sssata/load_cell_reader/FW/loadcellreader/scripts/noise_analysis.png

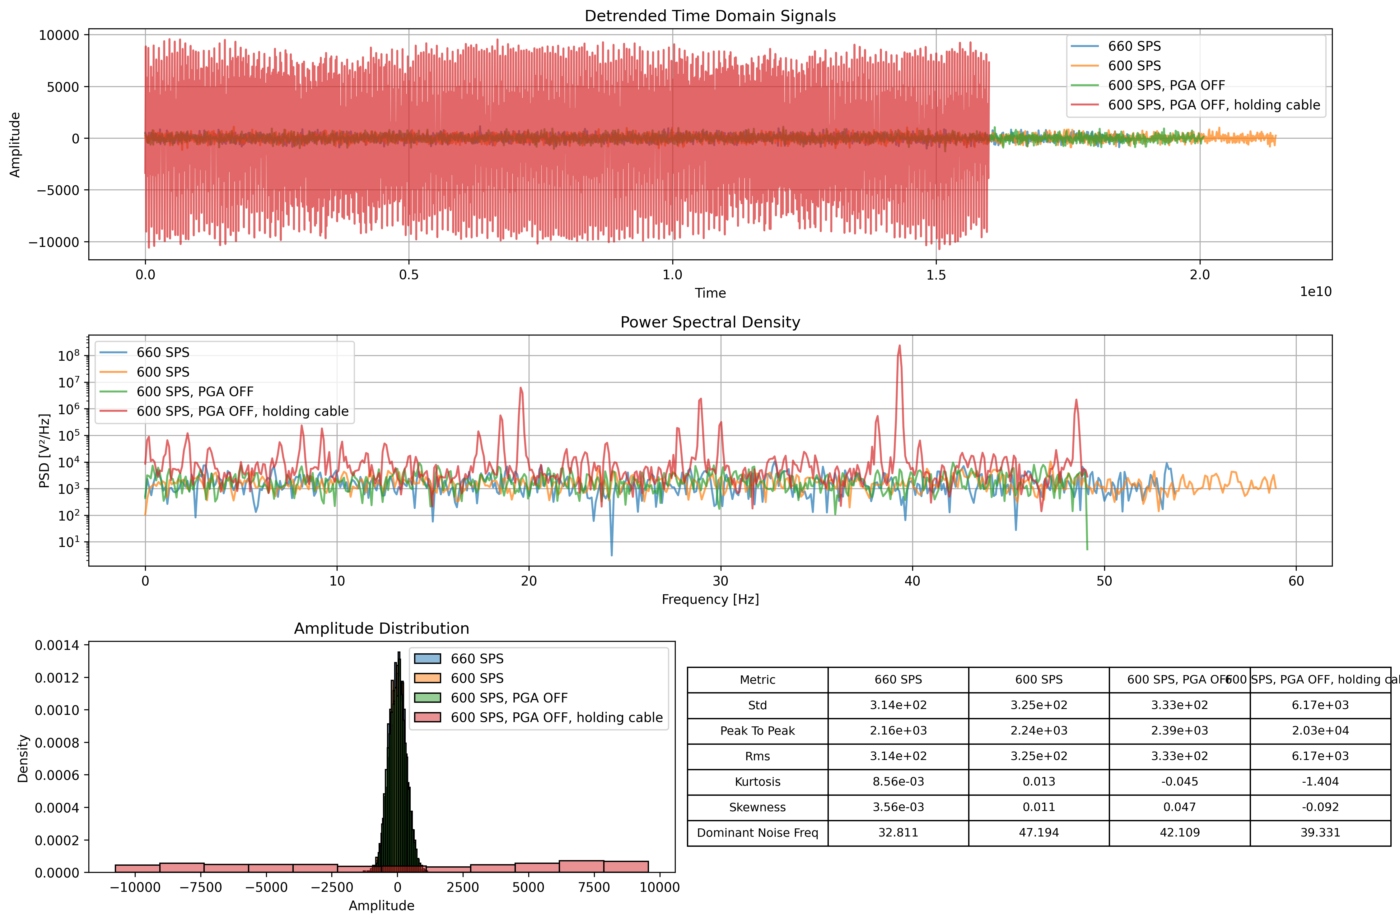
FW/loadcellreader/scripts/noise_analysis.png
