sssata/load_cell_reader/ECAD/ads1220_board/ads1220_board.kicad_pcb

## KiCad design ECAD/ads1220_board/ads1220_board.kicad_pcb (2024-11-20)

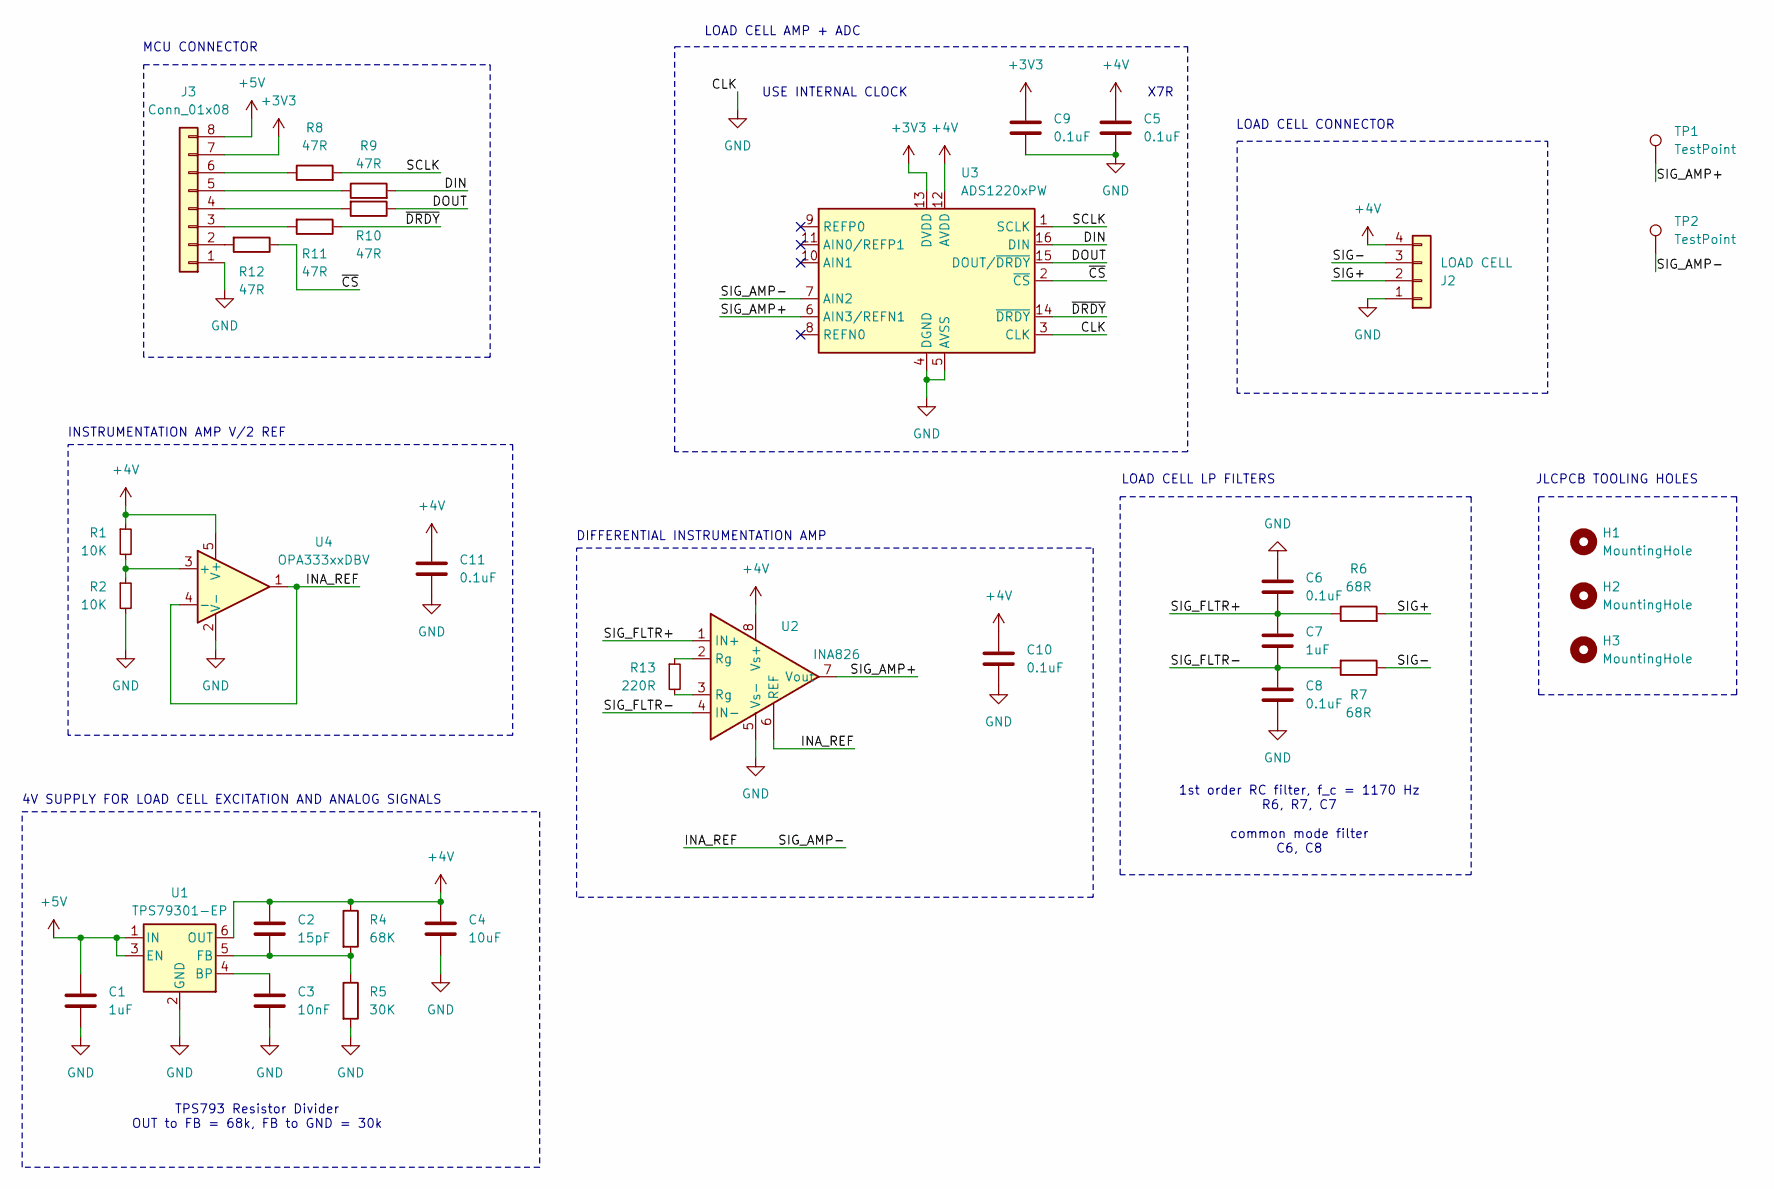
[picture p2: schematic ads1220_board.kicad_sch]

Parts:
C1, C7: 1uF; C_0402_1005Metric; JLC PN C52923
C2: 15pF; C_0402_1005Metric; JLC PN C1548
C3: 10nF; C_0402_1005Metric; JLC PN C15195
C4: 10uF; C_0603_1608Metric; JLC PN C19702
C5, C6, C8, C9, C10, C11: 0.1uF; C_0402_1005Metric; JLC PN C307331
H1, H2, H3: MountingHole; SMD Tooling Hole
J2: LOAD CELL; JST_PH_B4B-PH-K_1x04_P2.00mm_Vertical
J3: Conn_01x08; JST_PH_B8B-PH-K_1x08_P2.00mm_Vertical
R1, R2: 10K; R_0402_1005Metric; JLC PN C25744
R4: 68K; R_0603_1608Metric; JLC PN C23231
R5: 30K; R_0603_1608Metric; JLC PN C22984
R6, R7: 68R; R_0402_1005Metric; JLC PN C25131
R8, R9, R10, R11, R12: 47R; R_0603_1608Metric; JLC PN C23182
R13: 220R; R_0402_1005Metric; JLC PN C25091
TP1, TP2: TestPoint; TestPoint_Pad_1.0x1.0mm
U1: TPS79301-EP; SOT-23-6
U2: INA826; Texas_S-PDSO-G8_3x3mm_P0.65mm
U3: ADS1220xPW; TSSOP-16_4.4x5mm_P0.65mm
U4: OPA333xxDBV; SOT-23-5

Connections:
+3V3: C9.2, J3.7, U3.13 (DVDD)
+4V: C2.1, C4.1, C5.2, C10.2, C11.2, J2.4, R1.1, R4.1, U1.6 (OUT), U2.8 (Vs+), U3.12 (AVDD), U4.5 (V+)
+5V: C1.1, J3.8, U1.1 (IN), U1.3 (EN)
/DIN: R9.2, U3.16 (DIN)
/DOUT: R10.1, U3.15 (DOUT/~DRDY)
/INA_REF: TP2.1, U2.6 (REF), U3.7 (AIN2), U4.1, U4.4 (-)
/SCLK: R8.2, U3.1 (SCLK)
/SIG+: J2.2, R6.2
/SIG-: J2.3, R7.1
/SIG_AMP+: TP1.1, U2.7 (Vout), U3.6 (AIN3/REFN1)
/SIG_FLTR+: C6.2, C7.1, R6.1, U2.1 (IN+)
/SIG_FLTR-: C7.2, C8.1, R7.2, U2.4 (IN-)
/~CS: R12.1, U3.2 (~CS)
/~DRDY: R11.1, U3.14 (~DRDY)
GND: C1.2, C3.2, C4.2, C5.1, C6.1, C8.2, C9.1, C10.1, C11.1, J2.1, J3.1, R2.2, R5.2, U1.2 (GND), U2.5 (Vs-), U3.3 (CLK), U3.4 (DGND), U3.5 (AVSS), U4.2 (V-)
unnamed: J3.2, R12.2
unnamed: J3.3, R11.2
unnamed: J3.4, R10.2
unnamed: J3.5, R9.1
unnamed: J3.6, R8.1
unnamed: R13.1, U2.2 (Rg)
unnamed: R13.2, U2.3 (Rg)
unnamed: C3.1, U1.4 (BP)
unnamed: C2.2, R4.2, R5.1, U1.5 (FB)
unnamed: R1.2, R2.1, U4.3 (+)

Notes on the sheet:
X7R
INSTRUMENTATION AMP V/2 REF
JLCPCB TOOLING HOLES
LOAD CELL LP FILTERS
1st order RC filter, f_c = 1170 Hz R6, R7, C7 common mode filter C6, C8
LOAD CELL CONNECTOR
TPS793 Resistor Divider OUT to FB = 68k, FB to GND = 30k
MCU CONNECTOR
USE INTERNAL CLOCK
DIFFERENTIAL INSTRUMENTATION AMP
4V SUPPLY FOR LOAD CELL EXCITATION AND ANALOG SIGNALS
LOAD CELL AMP + ADC

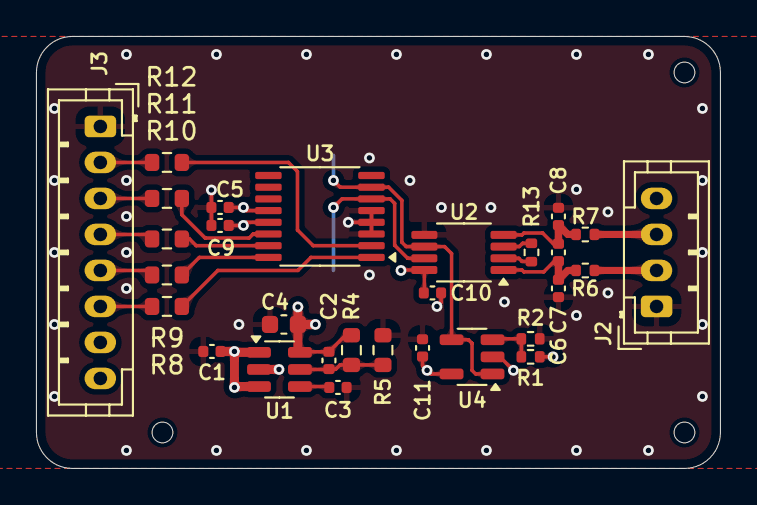
[picture p3: board ads1220_board.kicad_pcb from above]

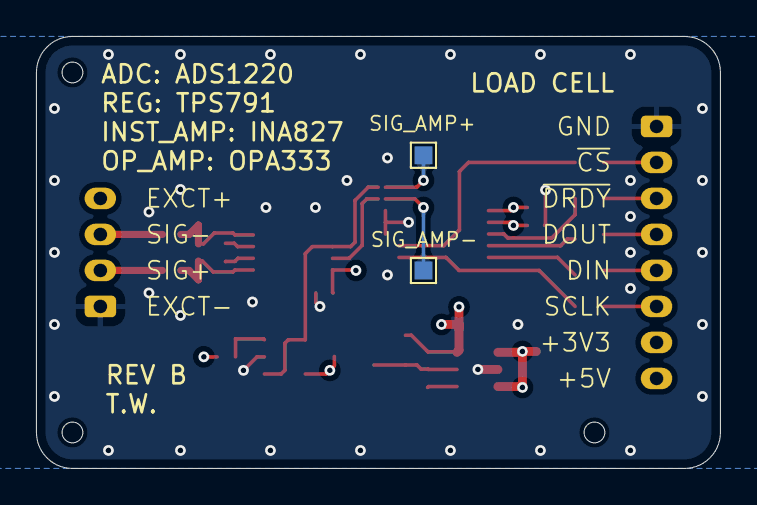
[picture p4: board ads1220_board.kicad_pcb from below]

Board: 4 copper layers, 38.0 x 24.0 mm, 34 parts (2 on the bottom side), 25 nets.
