sssata/load_cell_reader/ECAD/ads1260_board/ads1260_board.kicad_pcb

## KiCad design ECAD/ads1260_board/ads1260_board.kicad_pcb (2024-05-06)

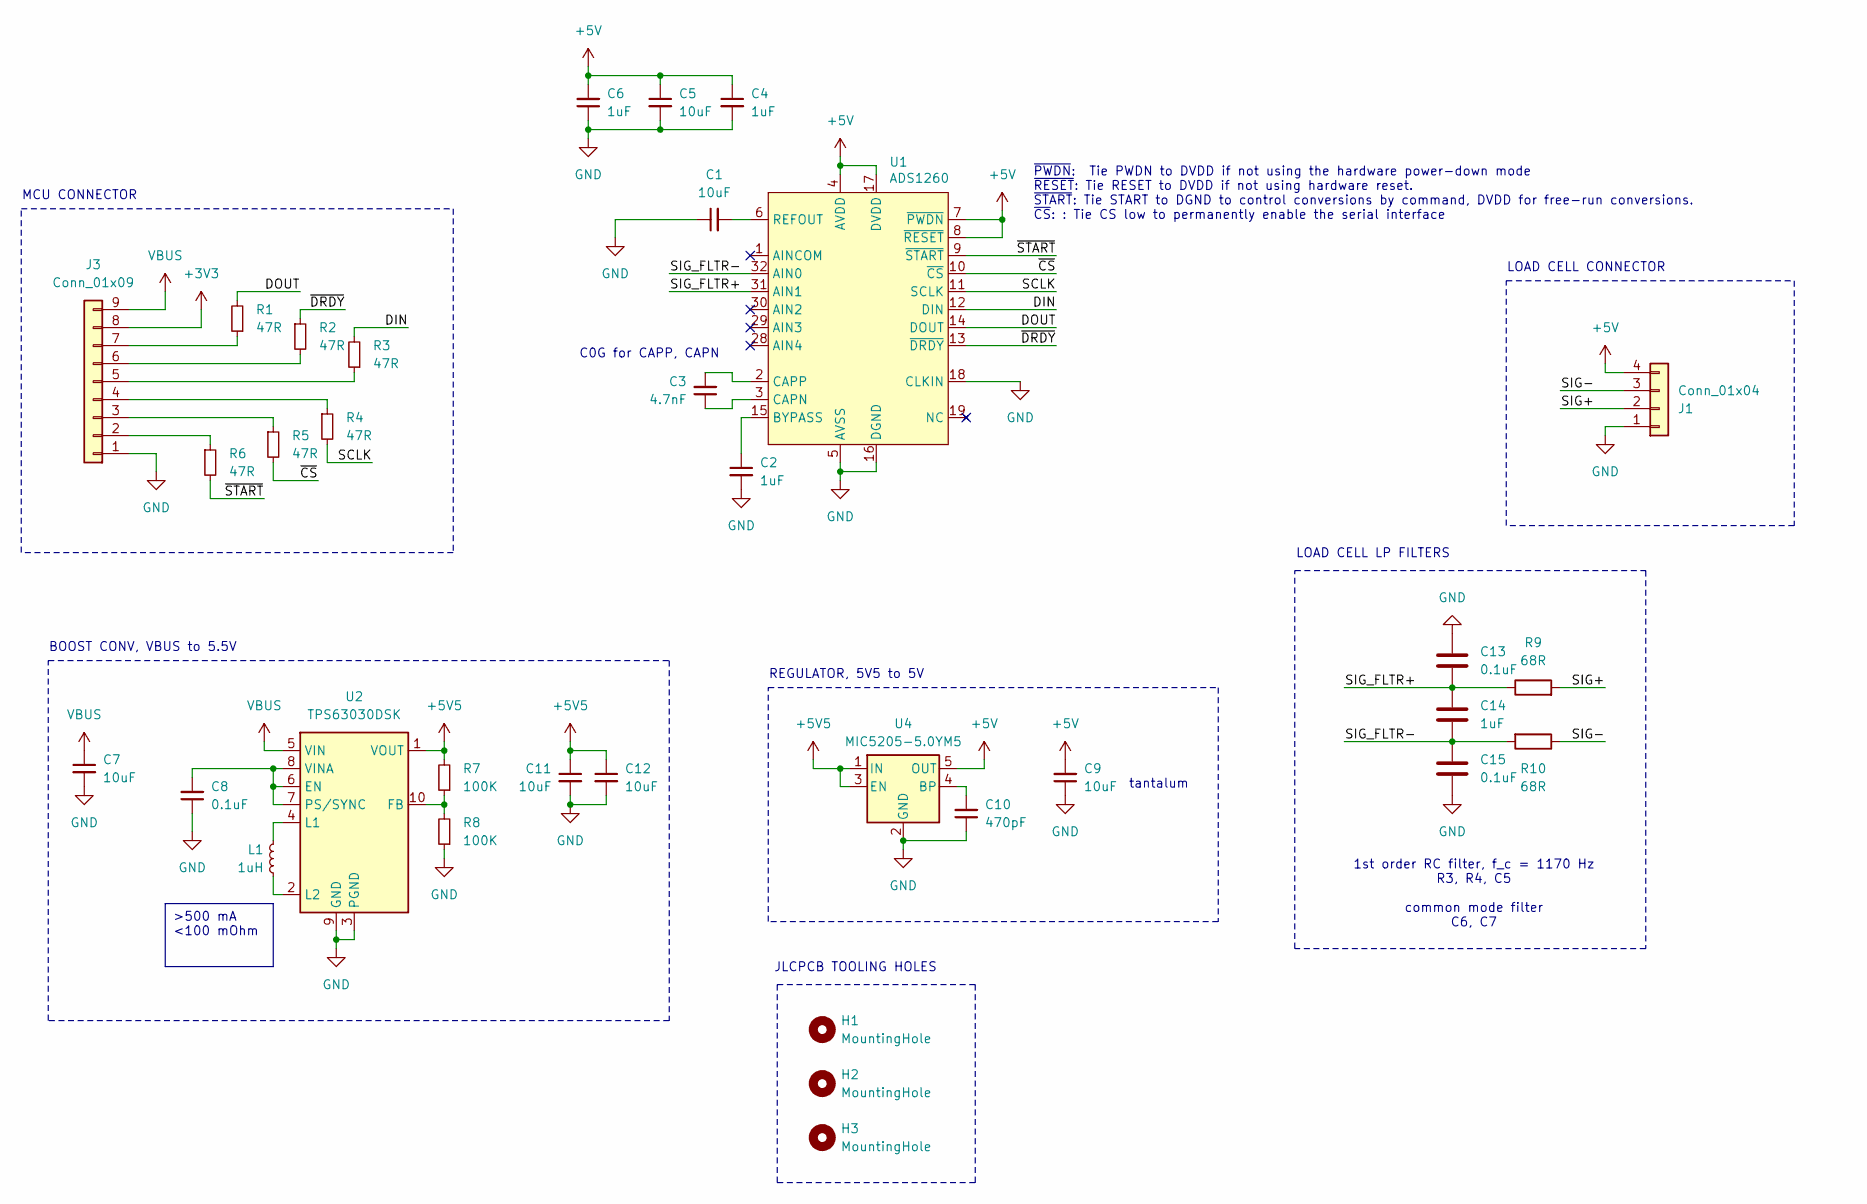
[picture p5: schematic ads1260_board.kicad_sch]

Parts:
C1, C5, C7, C9, C11, C12: 10uF; C_0603_1608Metric
C2, C4, C6, C14: 1uF; C_0402_1005Metric
C3: 4.7nF; C_0402_1005Metric
C8, C13, C15: 0.1uF; C_0402_1005Metric
C10: 470pF; C_0603_1608Metric
H1, H2, H3: MountingHole; SMD Tooling Hole
J1: Conn_01x04; JST_PH_B4B-PH-K_1x04_P2.00mm_Vertical
J3: Conn_01x09; JST_PH_B9B-PH-K_1x09_P2.00mm_Vertical
L1: 1uH; L_Murata_DFE201610P
R1, R2, R3, R4, R5, R6: 47R; R_0402_1005Metric
R7, R8: 100K; R_0402_1005Metric
R9, R10: 68R; R_0402_1005Metric
U1: ADS1260; VQFN-32-1EP_5x5mm_P0.5mm_EP3.15x3.15mm
U2: TPS63030DSK; WSON-10-1EP_2.5x2.5mm_P0.5mm_EP1.2x2mm
U4: MIC5205-5.0YM5; SOT-23-5

Connections:
+3V3: J3.8
+5V: C4.1, C5.1, C6.2, C9.2, J1.4, U1.4 (AVDD), U1.7 (~PWDN), U1.8 (~RESET), U1.17 (DVDD), U4.5 (OUT)
+5V5: C11.1, C12.1, R7.2, U2.1 (VOUT), U4.1 (IN), U4.3 (EN)
/DIN: R3.2, U1.12 (DIN)
/DOUT: R1.2, U1.14 (DOUT)
/SCLK: R4.2, U1.11 (SCLK)
/SIG+: J1.2, R9.2
/SIG-: J1.3, R10.1
/SIG_FLTR+: C13.2, C14.1, R9.1, U1.31 (AIN1)
/SIG_FLTR-: C14.2, C15.1, R10.2, U1.32 (AIN0)
/~CS: R5.2, U1.10 (~CS)
/~DRDY: R2.1, U1.13 (~DRDY)
/~START: R6.2, U1.9 (~START)
GND: C1.1, C2.2, C4.2, C5.2, C6.1, C7.2, C8.1, C9.1, C10.1, C11.2, C12.2, C13.1, C15.2, J1.1, J3.1, R8.1, U1.5 (AVSS), U1.16 (DGND), U1.18 (CLKIN), U1.33 (AVSS), U2.3 (PGND), U2.9 (GND), U2.11 (PGND), U4.2 (GND)
unnamed: J3.2, R6.1
unnamed: J3.3, R5.1
unnamed: J3.4, R4.1
unnamed: J3.5, R3.1
unnamed: J3.6, R2.2
unnamed: J3.7, R1.1
unnamed: C2.1, U1.15 (BYPASS)
unnamed: C3.1, U1.3 (CAPN)
unnamed: C3.2, U1.2 (CAPP)
unnamed: C1.2, U1.6 (REFOUT)
unnamed: C8.2, U2.6 (EN), U2.7 (PS/SYNC), U2.8 (VINA)
unnamed: R7.1, R8.2, U2.10 (FB)
unnamed: L1.2, U2.4 (L1)
unnamed: L1.1, U2.2 (L2)
unnamed: C10.2, U4.4 (BP)
VBUS: C7.1, J3.9, U2.5 (VIN)

Notes on the sheet:
>500 mA <100 mOhm
tantalum
REGULATOR, 5V5 to 5V
~{PWDN}: Tie PWDN to DVDD if not using the hardware power-down mode ~{RESET}: Tie RESET to DVDD if not using hardware reset. ~{START}: Tie START to DGND to control conversions by command, DVDD for free-run conversions. ~{CS}: : Tie CS low to permanently enable the serial interface
BOOST CONV, VBUS to 5.5V
MCU CONNECTOR
LOAD CELL LP FILTERS
1st order RC filter, f_c = 1170 Hz R3, R4, C5 common mode filter C6, C7
JLCPCB TOOLING HOLES
LOAD CELL CONNECTOR
C0G for CAPP, CAPN

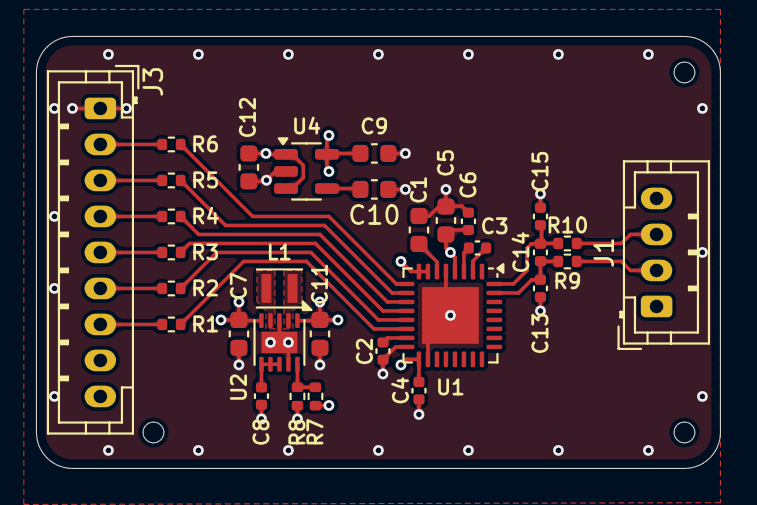
[picture p6: board ads1260_board.kicad_pcb from above]

Board: 4 copper layers, 38.0 x 24.0 mm, 34 parts (0 on the bottom side), 29 nets.
