sssata/load_cell_reader/ECAD/ads1115_board/ads1115_board.kicad_pcb

## KiCad design ECAD/ads1115_board/ads1115_board.kicad_pcb (2024-05-06)

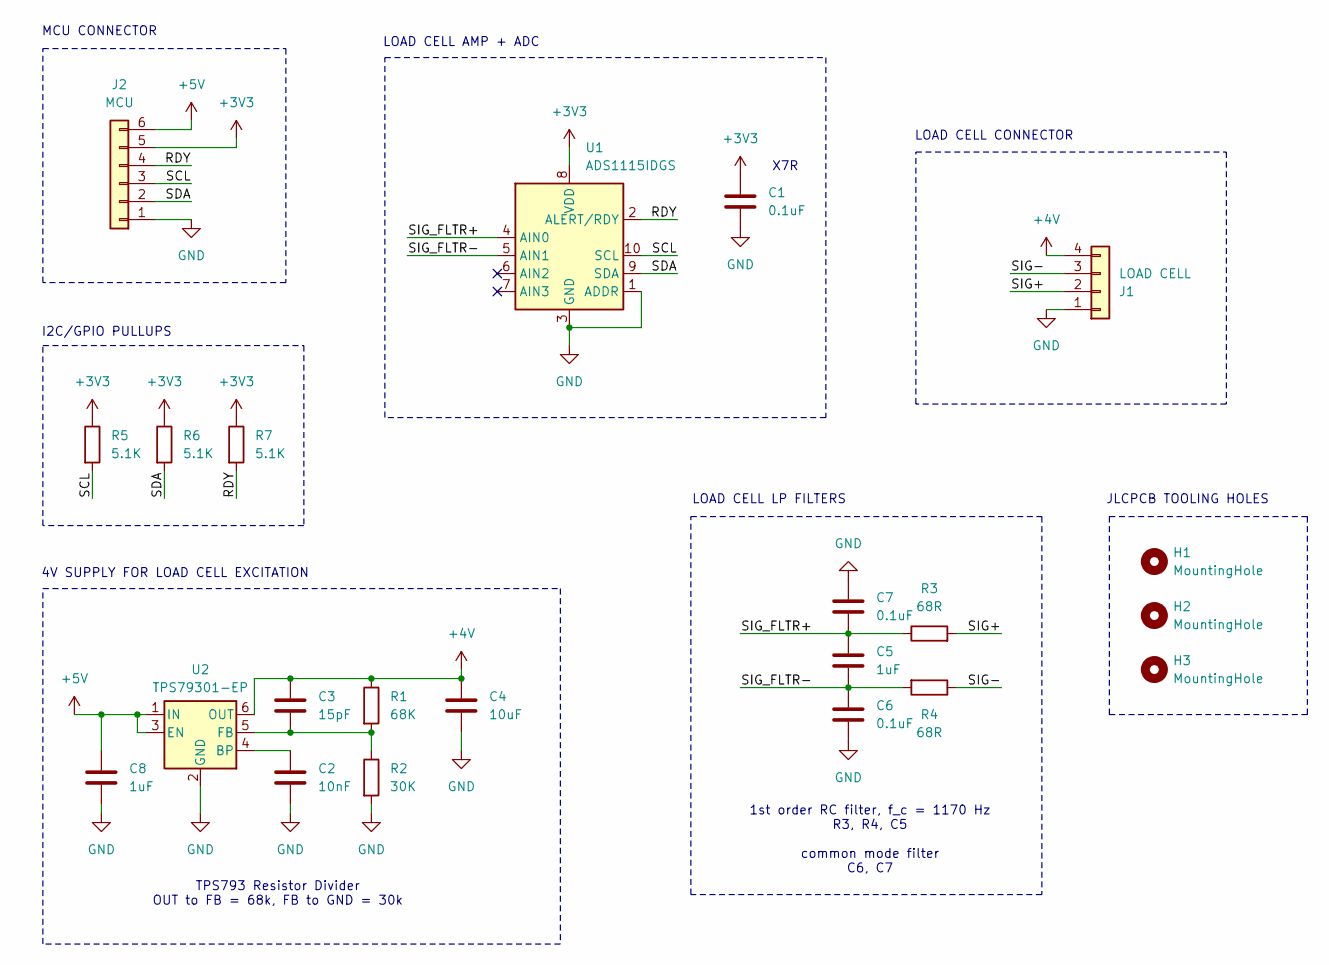
[picture p7: schematic ads1115_board.kicad_sch]

Parts:
C1, C6, C7: 0.1uF; C_0402_1005Metric
C2: 10nF; C_0402_1005Metric
C3: 15pF; C_0402_1005Metric
C4: 10uF; C_0603_1608Metric
C5, C8: 1uF; C_0402_1005Metric
H1, H2, H3: MountingHole; SMD Tooling Hole
J1: LOAD CELL; JST_PH_B4B-PH-K_1x04_P2.00mm_Vertical
J2: MCU; JST_PH_B6B-PH-K_1x06_P2.00mm_Vertical
R1: 68K; R_0402_1005Metric
R2: 30K; R_0402_1005Metric
R3, R4: 68R; R_0402_1005Metric
R5, R6, R7: 5.1K; R_0402_1005Metric
U1: ADS1115IDGS; TSSOP-10_3x3mm_P0.5mm
U2: TPS79301-EP; SOT-23-6

Connections:
+3V3: C1.2, J2.5, R5.1, R6.1, R7.1, U1.8 (VDD)
+4V: C3.1, C4.1, J1.4, R1.1, U2.6 (OUT)
+5V: C8.1, J2.6, U2.1 (IN), U2.3 (EN)
/RDY: J2.4, R7.2, U1.2 (ALERT/RDY)
/SCL: J2.3, R5.2, U1.10 (SCL)
/SDA: J2.2, R6.2, U1.9 (SDA)
/SIG+: J1.2, R3.2
/SIG-: J1.3, R4.1
/SIG_FLTR+: C5.1, C7.2, R3.1, U1.4 (AIN0)
/SIG_FLTR-: C5.2, C6.1, R4.2, U1.5 (AIN1)
GND: C1.1, C2.2, C4.2, C6.2, C7.1, C8.2, J1.1, J2.1, R2.2, U1.1 (ADDR), U1.3 (GND), U2.2 (GND)
unnamed: C2.1, U2.4 (BP)
unnamed: C3.2, R1.2, R2.1, U2.5 (FB)

Notes on the sheet:
LOAD CELL AMP + ADC
MCU CONNECTOR
1st order RC filter, f_c = 1170 Hz R3, R4, C5 common mode filter C6, C7
JLCPCB TOOLING HOLES
LOAD CELL CONNECTOR
TPS793 Resistor Divider OUT to FB = 68k, FB to GND = 30k
I2C/GPIO PULLUPS
LOAD CELL LP FILTERS
X7R
4V SUPPLY FOR LOAD CELL EXCITATION

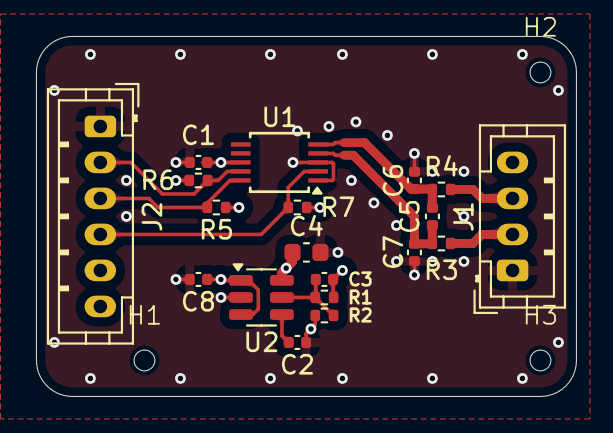
[picture p8: board ads1115_board.kicad_pcb from above]

Board: 4 copper layers, 30.0 x 20.0 mm, 22 parts (0 on the bottom side), 13 nets.
