sssata/load_cell_reader/FW/loadcellreader/src/pins.h

#pragma once

namespace Pins {

// PINS
constexpr int ONBOARD_LED = 25;

constexpr int ADS1115_RDY = 3;
constexpr int ADS1115_SDA = 4;
constexpr int ADS1115_SCL = 5;

constexpr int ADS1220_DRDY2 = 8;
constexpr int ADS1220_CS2 = 9;

constexpr int ADS1220_DRDY = 6;
constexpr int ADS1220_CS = 7;
constexpr int ADS1220_MISO = 4;
constexpr int ADS1220_MOSI = 3;
constexpr int ADS1220_SCK = 2;

}
