sssata/load_cell_reader/(commit log)

2024-05-12 add iir filter
    [raw_data.csv]
2024-07-08 update ads1220 schematic
    [BOM-ads1220_board.csv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]
2024-07-15 change from 2 ina to 1
    [ads1220_board.kicad_pcb, ads1220_board.kicad_sch]
2024-07-15 add ads1220 driver
2024-11-20 update, add second sensor
    [BOM-ads1220_board.csv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]
2024-11-26 Move adc reading to second core
